OE5AMP/OpenTrickler-RP2040-Controller/README.md

OpenTrickler RP2040 Controller
==============================

Build project

    cd build
    cmake .. -DPICO_BOARD=pico_w -DCMAKE_BUILD_TYPE=Debug
    make -j8
