OE5AMP/OpenTrickler-RP2040-Controller/pico_expansion_board/reference_documents/Raspberry Pi-Pico-W-pinout.png

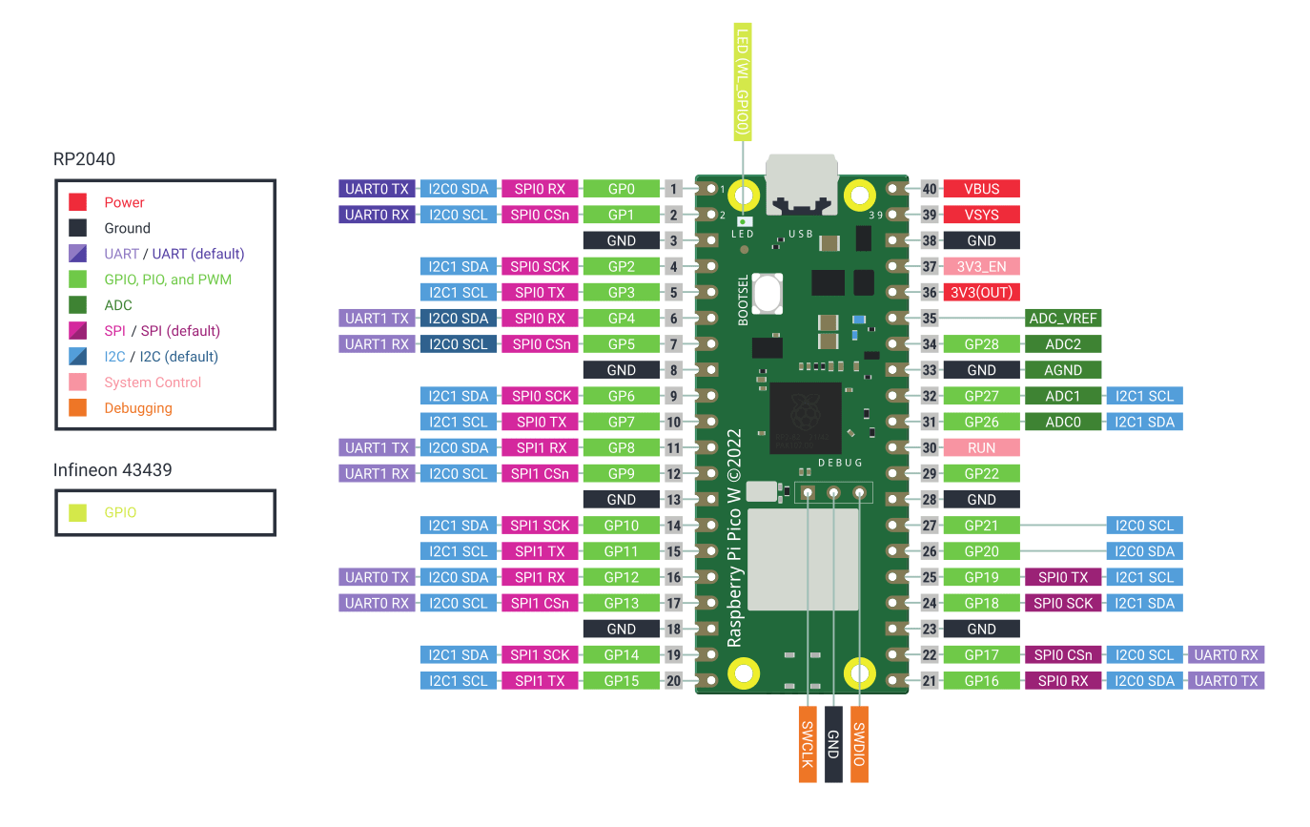
pico_expansion_board/reference_documents/Raspberry Pi-Pico-W-pinout.png
