OE5AMP/OpenTrickler-RP2040-Controller/pico_expansion_board/3D_Models/BTT TMC2209-V1.2 v2.step

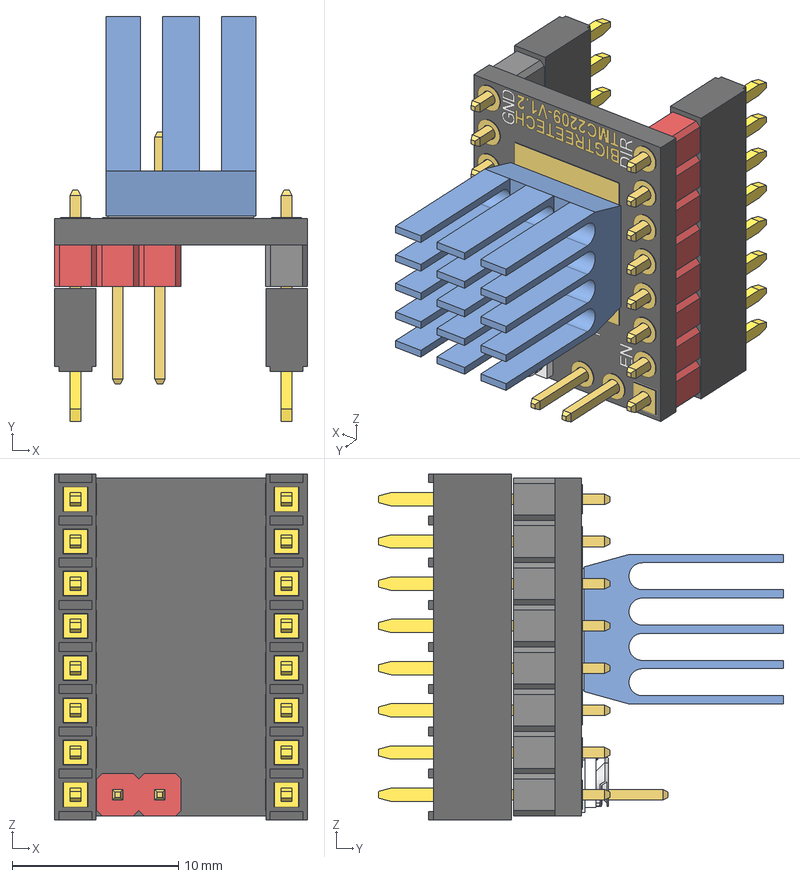
[picture p3: CAD file, 2023-03-02]
pico_expansion_board/3D_Models/BTT TMC2209-V1.2 v2.step
15.2 x 24.4 x 20.8 mm
TMC2209_board
Pin_Header_1x2_red
Pin_Header_1x8_red
Pin_Header_1x8_black
EVM-3E___ _________
TMC2209_heatsink
8er Pin Header Female x 2
