OE5AMP/OpenTrickler-RP2040-Controller/pico_expansion_board/TPS5450DDAR.step

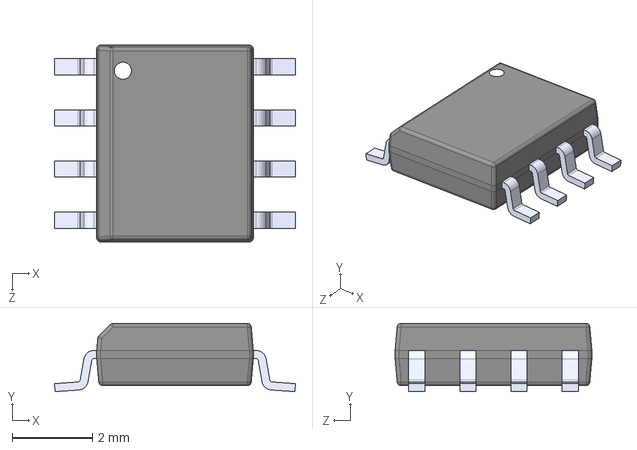
[picture p4: CAD file, 2023-02-26]
pico_expansion_board/TPS5450DDAR.step
6.00 x 1.70 x 4.90 mm
