OE5AMP/OpenTrickler-RP2040-Controller/pico_expansion_board/pico_expansion_board.kicad_pcb

## KiCad design pico_expansion_board/pico_expansion_board.kicad_pcb (2023-03-06)

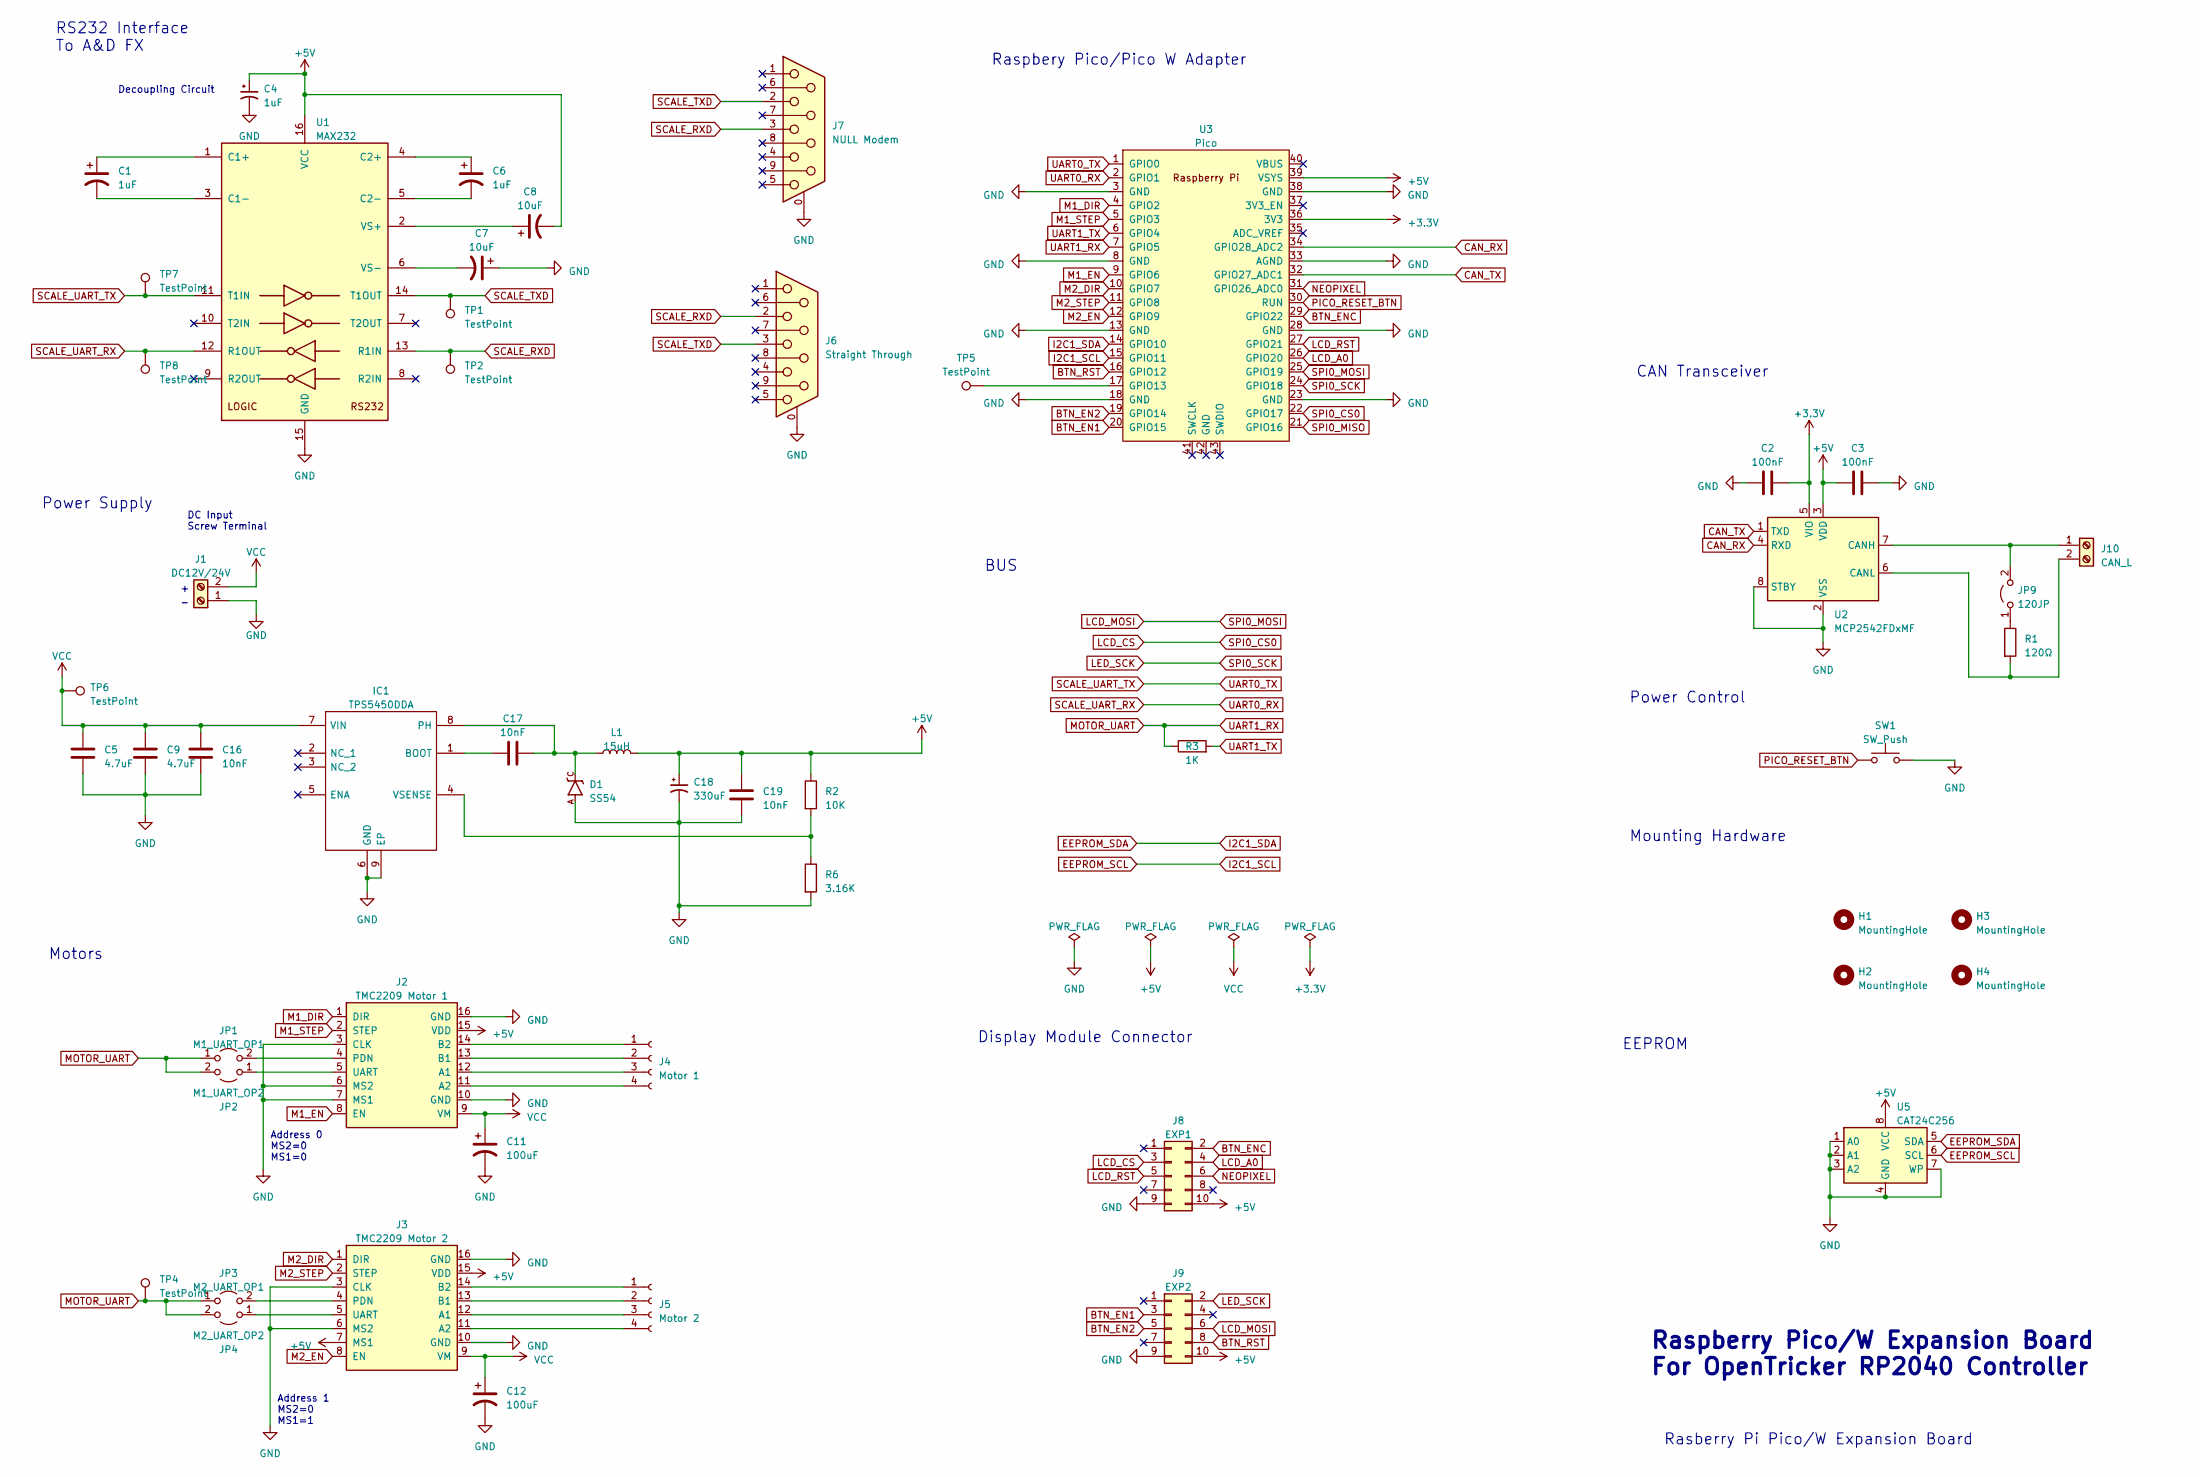
[picture p5: schematic pico_expansion_board.kicad_sch]

Parts:
C1, C4, C6: 1uF; C_0805_2012Metric
C2, C3: 100nF; C_0805_2012Metric
C5, C9: 4.7uF; C_0805_2012Metric
C7, C8: 10uF; C_0805_2012Metric
C11, C12: 100uF; CP_Elec_6.3x7.7
C16, C17, C19: 10nF; C_0805_2012Metric
C18: 330uF; CP_Elec_10x10.5
D1: SS54; DO-214AC
H1, H2, H3, H4: MountingHole; MountingHole_3.2mm_M3_Pad
IC1: TPS5450DDA; SOIC127P600X170-9N; Mouser Part Number 595-TPS5450DDA
J1: DC12V/24V; TerminalBlock_bornier-2_P5.08mm
J2: TMC2209 Motor 1; Conn_StepStick
J3: TMC2209 Motor 2; Conn_StepStick
J4: Motor 1; JST_XH_B4B-XH-AM_1x04_P2.50mm_Vertical
J5: Motor 2; JST_XH_B4B-XH-AM_1x04_P2.50mm_Vertical
J6: Straight Through; DSUB-9_Male_Horizontal_P2.77x2.84mm_EdgePinOffset7.70mm_Hou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
J7: NULL Modem; DSUB-9_Male_Horizontal_P2.77x2.84mm_EdgePinOffset7.70mm_Hou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
J8: EXP1; IDC-Header_2x05_P2.54mm_Vertical
J9: EXP2; IDC-Header_2x05_P2.54mm_Vertical
J10: CAN_L; TerminalBlock_bornier-2_P5.08mm
JP1: M1_UART_OP1; PinHeader_1x02_P2.00mm_Vertical
JP2: M1_UART_OP2; PinHeader_1x02_P2.00mm_Vertical
JP3: M2_UART_OP1; PinSocket_1x02_P2.00mm_Vertical
JP4: M2_UART_OP2; PinSocket_1x02_P2.00mm_Vertical
JP9: 120JP; PinHeader_1x02_P2.00mm_Vertical
L1: 15uH; Power Inductor 10x11
R1: 120Ω; R_0805_2012Metric
R2: 10K; R_0805_2012Metric
R3: 1K; R_0805_2012Metric
R6: 3.16K; R_0805_2012Metric
SW1: SW_Push; SW_Push_1P1T_NO_6x6mm_H9.5mm
TP1, TP2, TP4, TP5, TP6, TP7, TP8: TestPoint; TestPoint_Pad_2.0x2.0mm
U1: MAX232; SOIC-16_3.9x9.9mm_P1.27mm
U2: MCP2542FDxMF; SO-8_3.9x4.9mm_P1.27mm
U3: Pico; RPi_Pico_SMD_TH
U5: CAT24C256; SO-8_3.9x4.9mm_P1.27mm

Connections:
+3.3V: C2.2, U2.5 (VIO), U3.36 (3V3)
+5V: C3.1, C4.1, C8.2, C18.1, C19.1, J2.15 (VDD), J3.7 (MS1), J3.15 (VDD), J8.10, J9.10, L1.2, R2.1, U1.16 (VCC), U2.3 (VDD), U3.39 (VSYS), U5.8 (VCC)
BTN_EN1: J9.3, U3.20 (GPIO15)
BTN_EN2: J9.5, U3.19 (GPIO14)
BTN_ENC: J8.2, U3.29 (GPIO22)
BTN_RST: J9.8, U3.16 (GPIO12)
CAN_RX: U2.4 (RXD), U3.34 (GPIO28_ADC2)
CAN_TX: U2.1 (TXD), U3.32 (GPIO27_ADC1)
EEPROM_SCL: U3.15 (GPIO11), U5.6 (SCL)
EEPROM_SDA: U3.14 (GPIO10), U5.5 (SDA)
GND: C2.1, C3.2, C4.2, C5.2, C7.1, C9.2, C11.2, C12.2, C16.2, C18.2, C19.2, D1.A, IC1.6 (GND), IC1.9 (EP), J1.1, J2.3 (CLK), J2.6 (MS2), J2.7 (MS1), J2.10 (GND), J2.16 (GND), J3.3 (CLK), J3.6 (MS2), J3.10 (GND), J3.16 (GND), J6.0 (PAD), J7.0 (PAD), J8.9, J9.9, R6.2, SW1.2, U1.15 (GND), U2.2 (VSS), U2.8 (STBY), U3.3 (GND), U3.8 (GND), U3.13 (GND), U3.18 (GND), U3.23 (GND), U3.28 (GND), U3.33 (AGND), U3.38 (GND), U5.1 (A0), U5.2 (A1), U5.3 (A2), U5.4 (GND), U5.7 (WP)
LCD_A0: J8.4, U3.26 (GPIO20)
LCD_CS: J8.3, U3.22 (GPIO17)
LCD_MOSI: J9.6, U3.25 (GPIO19)
LCD_RST: J8.5, U3.27 (GPIO21)
LED_SCK: J9.2, U3.24 (GPIO18)
M1_DIR: J2.1 (DIR), U3.4 (GPIO2)
M1_EN: J2.8 (EN), U3.9 (GPIO6)
M1_STEP: J2.2 (STEP), U3.5 (GPIO3)
M2_DIR: J3.1 (DIR), U3.10 (GPIO7)
M2_EN: J3.8 (EN), U3.12 (GPIO9)
M2_STEP: J3.2 (STEP), U3.11 (GPIO8)
MOTOR_UART: JP1.1 (A), JP2.2 (B), JP3.1 (A), JP4.2 (B), R3.1, TP4.1, U3.7 (GPIO5)
NEOPIXEL: J8.6, U3.31 (GPIO26_ADC0)
unnamed: C17.1, IC1.1 (BOOT)
unnamed: C17.2, D1.C, IC1.8 (PH), L1.1
unnamed: IC1.4 (VSENSE), R2.2, R6.1
unnamed: J2.12 (A1), J4.3
unnamed: J2.11 (A2), J4.4
unnamed: J2.13 (B1), J4.2
unnamed: J2.14 (B2), J4.1
unnamed: J2.4 (PDN), JP1.2 (B)
unnamed: J2.5 (UART), JP2.1 (A)
unnamed: J3.12 (A1), J5.3
unnamed: J3.11 (A2), J5.4
unnamed: J3.13 (B1), J5.2
unnamed: J3.14 (B2), J5.1
unnamed: J3.4 (PDN), JP3.2 (B)
unnamed: J3.5 (UART), JP4.1 (A)
unnamed: J10.1, JP9.2 (B), U2.7 (CANH)
unnamed: J10.2, R1.2, U2.6 (CANL)
unnamed: JP9.1 (A), R1.1
unnamed: C1.1, U1.1 (C1+)
unnamed: C1.2, U1.3 (C1-)
unnamed: C6.1, U1.4 (C2+)
unnamed: C6.2, U1.5 (C2-)
unnamed: C8.1, U1.2 (VS+)
unnamed: C7.2, U1.6 (VS-)
unnamed: TP5.1, U3.17 (GPIO13)
PICO_RESET_BTN: SW1.1, U3.30 (RUN)
SCALE_RXD: J6.2, J7.3, TP2.1, U1.13 (R1IN)
SCALE_TXD: J6.3, J7.2, TP1.1, U1.14 (T1OUT)
SCALE_UART_RX: TP8.1, U1.12 (R1OUT), U3.2 (GPIO1)
SCALE_UART_TX: TP7.1, U1.11 (T1IN), U3.1 (GPIO0)
SPI0_MISO: U3.21 (GPIO16)
UART1_TX: R3.2, U3.6 (GPIO4)
VCC: C5.1, C9.1, C11.1, C12.1, C16.1, IC1.7 (VIN), J1.2, J2.9 (VM), J3.9 (VM), TP6.1

Notes on the sheet:
Motors
Address 1 MS2=0 MS1=1
BUS
Mounting Hardware
EEPROM
Display Module Connector
Raspberry Pico/W Expansion Board For OpenTricker RP2040 Controller
Decoupling Circuit
DC Input Screw Terminal
RS232 Interface To A&D FX
Power Supply
Rasberry Pi Pico/W Expansion Board
Power Control
CAN Transceiver
Raspbery Pico/Pico W Adapter
Address 0 MS2=0 MS1=0

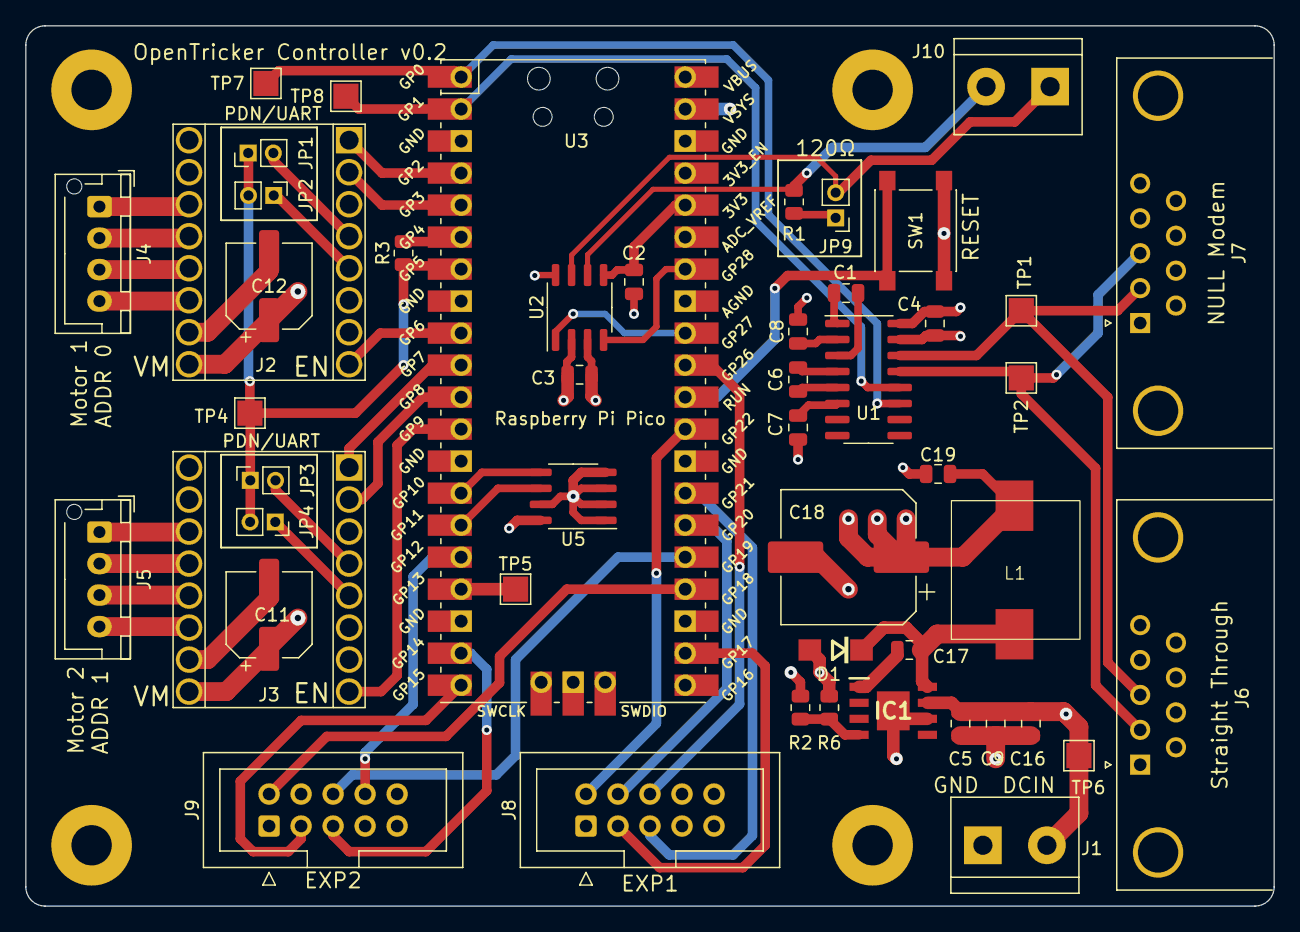
[picture p6: board pico_expansion_board.kicad_pcb from above]

Board: 4 copper layers, 99.1 x 69.8 mm, 53 parts (0 on the bottom side), 56 nets.
