OE5AMP/OpenTrickler-RP2040-Controller/src/rotary_button.cpp

// 
//            -----
//        5V |10  9 | GND
//        -- | 8  7 | --
//    (DIN)  | 6  5#| (RESET)
//  (LCD_A0) | 4  3 | (LCD_CS)
// (BTN_ENC) | 2  1 | --
//            ------
//             EXP1
//            -----
//        5V |10  9 | GND
//   (RESET) | 8  7 | --
//   (MOSI)  | 6  5#| (EN2)
//        -- | 4  3 | (EN1)
//  (LCD_SCK)| 2  1 | --
//            ------
//             EXP2
// 
// For Pico W
// EXP1_2 (BTN_ENC) <-> PIN29 (GP22)
// EXP2_5 (ENCODER2) <-> PIN19 (GP14)
// EXP2_3 (ENCODER1) <-> PIN20 (GP15)
// EXP2_8 (BTN_RST) <-> PIN16 (GP12)

#include <stdio.h>
#include <stdint.h>
#include "pico/stdlib.h"
#include <FreeRTOS.h>
#include <queue.h>
#include "configuration.h"
#include "gpio_irq_handler.h"
#include "rotary_button.h"


// Statics (to be shared between IRQ and tasks)
QueueHandle_t encoder_event_queue = NULL;


void _isr_on_encoder_update(uint gpio, uint32_t event){
    static uint8_t state = 2;
    static int8_t count = 0;

    bool en1 = gpio_get(BUTTON0_ENCODER_PIN1);
    bool en2 = gpio_get(BUTTON0_ENCODER_PIN2);

    switch (state) {
        case 0: {
            if (en1) {
                count += 1;
                state = 1;
            }
            else if (en2) {
                count -= 1;
                state = 3;
            }
            break;
        }
        case 1: {
            if (!en1) {
                count -= 1;
                state = 0;
            }
            else if (en2) {
                count += 1;
                state = 2;
            }
            break;
        }
        case 2: {
            if (!en1) {
                count += 1;
                state = 3;
            }
            else if (!en2) {
                count -= 1;
                state = 1;
            }
            break;
        }
        case 3: {
            if (!en1) {
                count += 1;
                state = 0;
            }
            else if (en2) {
                count -= 1;
                state = 2;
            }
            break;
        }
        default:
            break;
    }

    ButtonEncoderEvent_t button_encoder_event;
    if (count >= 4) {
        count = 0;
        button_encoder_event = BUTTON_ENCODER_ROTATE_CW;
        if (encoder_event_queue) {
            xQueueSendFromISR(encoder_event_queue, &button_encoder_event, NULL);
        }
    }
    else if (count <= -4) {
        count = 0;
        button_encoder_event = BUTTON_ENCODER_ROTATE_CCW;
        if (encoder_event_queue) {
            xQueueSendFromISR(encoder_event_queue, &button_encoder_event, NULL);
        }
    }
}

void _isr_on_button_enc_update(uint gpio, uint32_t event) {
    static TickType_t last_call_time = 0;
    const TickType_t debounce_timeout_ticks = pdMS_TO_TICKS(250);

    // Button debounce
    TickType_t current_call_time = xTaskGetTickCountFromISR();
     if ((current_call_time - last_call_time) > debounce_timeout_ticks) {
        ButtonEncoderEvent_t button_encoder_event = BUTTON_ENCODER_PRESSED;
        xQueueSendFromISR(encoder_event_queue, &button_encoder_event, NULL);
    }
    last_call_time = current_call_time;
}

void _isr_on_button_rst_update(uint gpio, uint32_t event) {
    static TickType_t last_call_time = 0;
    const TickType_t debounce_timeout_ticks = pdMS_TO_TICKS(250);

    // Button debounce
    TickType_t current_call_time = xTaskGetTickCountFromISR();
    if ((current_call_time - last_call_time) > debounce_timeout_ticks) {
        ButtonEncoderEvent_t button_encoder_event = BUTTON_RST_PRESSED;
        xQueueSendFromISR(encoder_event_queue, &button_encoder_event, NULL);
    }
    last_call_time = current_call_time;
}
  

void button_init() {
    printf("Initializing Button Task -- ");
    // Configure button encoder
    gpio_init(BUTTON0_ENCODER_PIN1);
    gpio_set_dir(BUTTON0_ENCODER_PIN1, GPIO_IN);
    gpio_pull_up(BUTTON0_ENCODER_PIN1);

    gpio_init(BUTTON0_ENCODER_PIN2);
    gpio_set_dir(BUTTON0_ENCODER_PIN2, GPIO_IN);
    gpio_pull_up(BUTTON0_ENCODER_PIN2);

    // Configure button encoder
    gpio_init(BUTTON0_ENC_PIN);
    gpio_set_dir(BUTTON0_ENC_PIN, GPIO_IN);
    gpio_pull_up(BUTTON0_ENC_PIN);

    // // Configure button reset
    gpio_init(BUTTON0_RST_PIN);
    gpio_set_dir(BUTTON0_RST_PIN, GPIO_IN);
    gpio_pull_up(BUTTON0_RST_PIN);

    irq_handler.register_interrupt(BUTTON0_ENCODER_PIN1, gpio_irq_handler::irq_event::change, _isr_on_encoder_update);
    irq_handler.register_interrupt(BUTTON0_ENCODER_PIN2, gpio_irq_handler::irq_event::change, _isr_on_encoder_update);
    irq_handler.register_interrupt(BUTTON0_ENC_PIN, gpio_irq_handler::irq_event::fall, _isr_on_button_enc_update);
    irq_handler.register_interrupt(BUTTON0_RST_PIN, gpio_irq_handler::irq_event::fall, _isr_on_button_rst_update);

    encoder_event_queue = xQueueCreate(5, sizeof(ButtonEncoderEvent_t));
    if (encoder_event_queue == 0) {
        assert(false);
    }

    printf("done\n");
}


// void button_task(void *p){
    

//     while (true){
//         ButtonEncoderEvent_t button_encoder_event;
//         xQueueReceive(encoder_event_queue, &button_encoder_event, portMAX_DELAY);
//         if (button_encoder_event & BUTTON_ENCODER_ROTATE_CW) {
//             printf("Rotating CW\n");
//         }
//         if (button_encoder_event & BUTTON_ENCODER_ROTATE_CCW) {
//             printf("Rotating CCW\n");
//         }
//         if (button_encoder_event & BUTTON_ENCODER_PRESSED) {
//             printf("Button Pressed\n");
//         }
//         if (button_encoder_event & BUTTON_RST_PRESSED) {
//             printf("RST Pressed\n");
//         }
//     }
// }
