OE5AMP/OpenTrickler-RP2040-Controller/(commit log)

2023-02-23 Initial commit of pcb design
    [pico_expansion_board.kicad_pcb, pico_expansion_board.kicad_sch]
2023-02-23 Re-arrange component location
    [pico_expansion_board.kicad_sch]
2023-02-23 Add external eeprom
    [pico_expansion_board.kicad_sch]
2023-02-26 Update PCB and schematic design
    [TPS5450DDAR.step, pico_expansion_board.kicad_pcb, pico_expansion_board.kicad_sch, pico_expansion_board_v1.kicad_pcb]
2023-03-02 Update design
    [pico_expansion_board-B_Cu.gbr, pico_expansion_board-B_Mask.gbr, pico_expansion_board-B_Paste.gbr, pico_expansion_board-B_Silkscreen.gbr, pico_expansion_board-CuBottom.gbr, pico_expansion_board-CuIn1.gbr, pico_expansion_board-CuIn2.gbr, pico_expansion_board-CuTop.gbr]
2023-03-02 Add 3d models for pico and stepper drivers
    [BTT TMC2209-V1.2 v2.step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]
2023-03-02 Add export model
    [pico_expansion_board.kicad_pcb]
2023-03-03 Update production file, update STEP models
    [pico_expansion_board-CuBottom.gbr, pico_expansion_board-CuIn1.gbr, pico_expansion_board-CuIn2.gbr, pico_expansion_board-CuTop.gbr, pico_expansion_board-EdgeCuts.gbr, pico_expansion_board-MaskBottom.gbr, pico_expansion_board-MaskTop.gbr, pico_expansion_board-NPTH.drl]
2023-03-05 Update to v0.2, include additional caps for StepStick driver VM input
    [pico_expansion_board-CuBottom.gbr, pico_expansion_board-CuIn1.gbr, pico_expansion_board-CuIn2.gbr, pico_expansion_board-CuTop.gbr, pico_expansion_board-EdgeCuts.gbr, pico_expansion_board-MaskBottom.gbr, pico_expansion_board-MaskTop.gbr, pico_expansion_board-NPTH.drl]
2023-03-06 Add new BOM
    [BOM-pico_expansion_board.csv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]
2023-03-06 Minor adjustment to the VCC plane
    [pico_expansion_board-CuBottom.gbr, pico_expansion_board-CuIn1.gbr, pico_expansion_board-CuIn2.gbr, pico_expansion_board-CuTop.gbr, pico_expansion_board-EdgeCuts.gbr, pico_expansion_board-MaskBottom.gbr, pico_expansion_board-MaskTop.gbr, pico_expansion_board-NPTH.drl]
2023-03-06 Create BOM file
    [pico_expansion_board_with_lcsc.csv]
